kylemanna/kicad-library/README.md

# kicad-library
My personal KiCAD library
