kylemanna/kicad-library/3d/Molex_PicoBlade_530470710.step

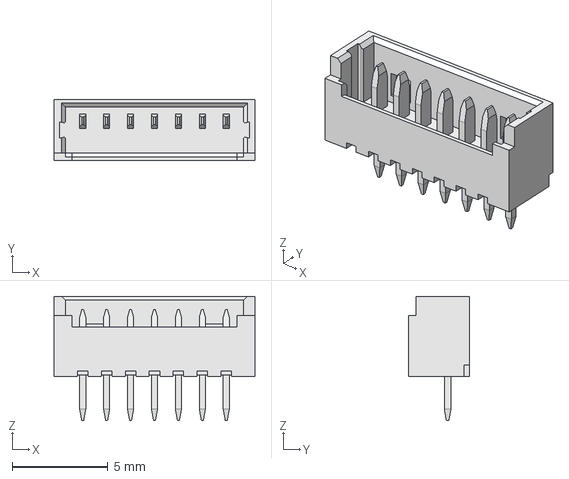
[picture p1: CAD file, 2016-03-12]
3d/Molex_PicoBlade_530470710.step
10.5 x 3.20 x 6.50 mm
