kylemanna/kicad-library/3d/Molex_PicoBlade_530470310.step

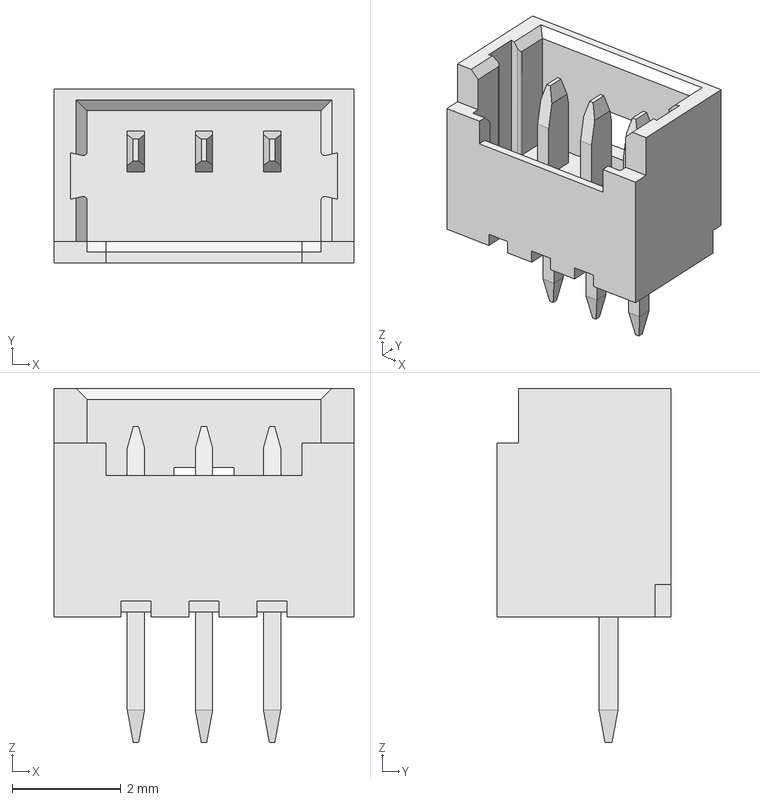
[picture p2: CAD file, 2016-03-12]
3d/Molex_PicoBlade_530470310.step
5.50 x 3.20 x 6.50 mm
