kylemanna/kicad-library/3d/Molex_PicoBlade_530470210.step

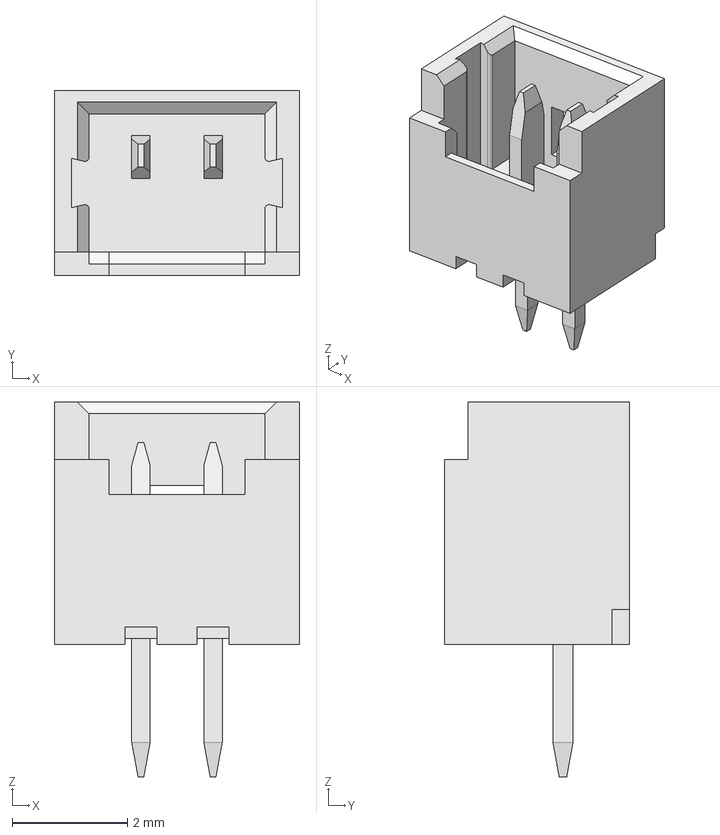
[picture p3: CAD file, 2016-03-12]
3d/Molex_PicoBlade_530470210.step
4.25 x 3.20 x 6.50 mm
