kylemanna/kicad-library/3d/B4B-XH-A.step

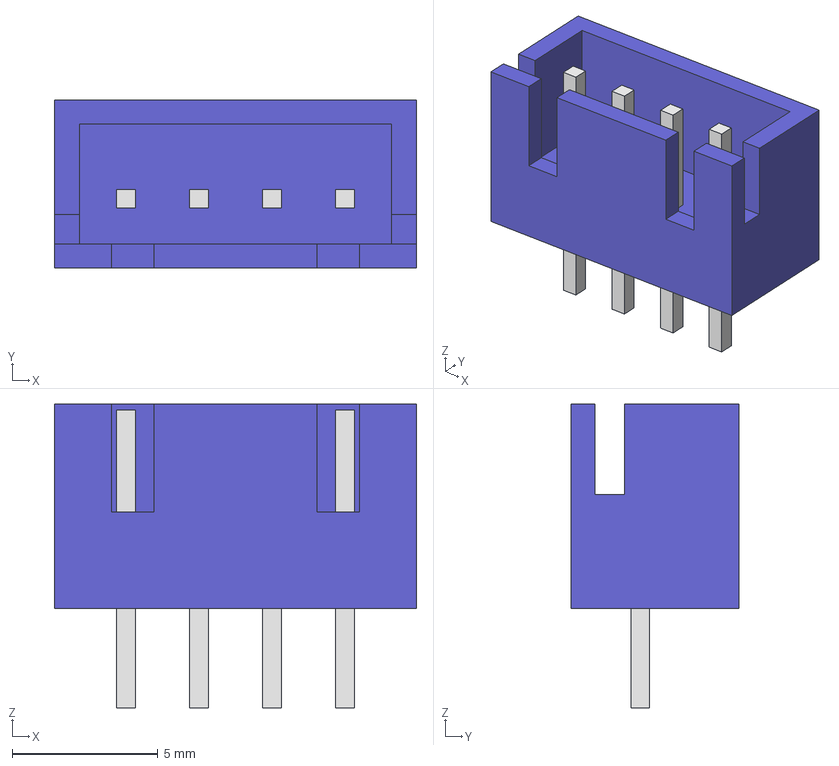
[picture p4: CAD file, 2016-02-24]
3d/B4B-XH-A.step
12.4 x 5.75 x 10.4 mm
