kylemanna/kicad-library/3d/B2B-XH-A.step

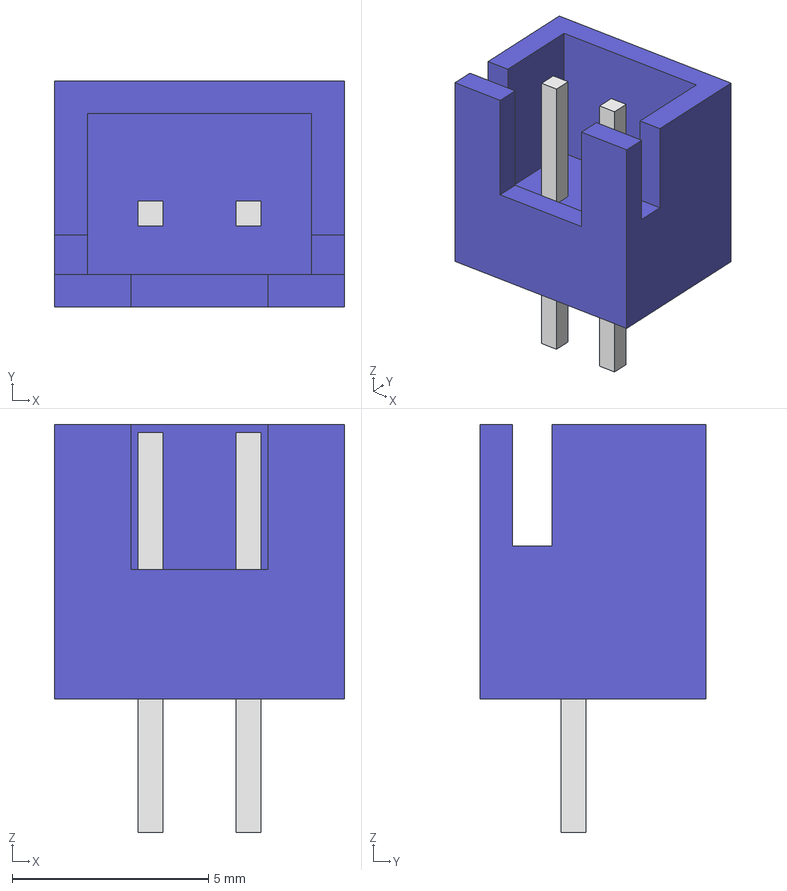
[picture p5: CAD file, 2016-02-20]
3d/B2B-XH-A.step
7.40 x 5.75 x 10.4 mm
