kylemanna/kicad-library/3d/LGA-16.step

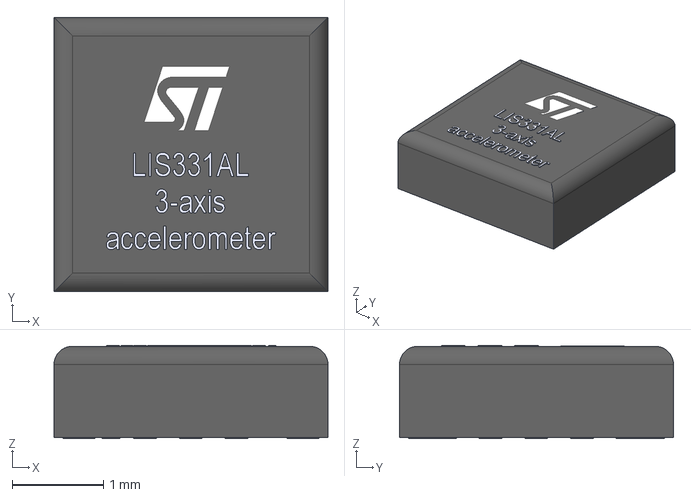
[picture p6: CAD file, 2016-02-16]
3d/LGA-16.step
3.00 x 3.00 x 1.02 mm
