kylemanna/kicad-library/3d/ABS07L.step

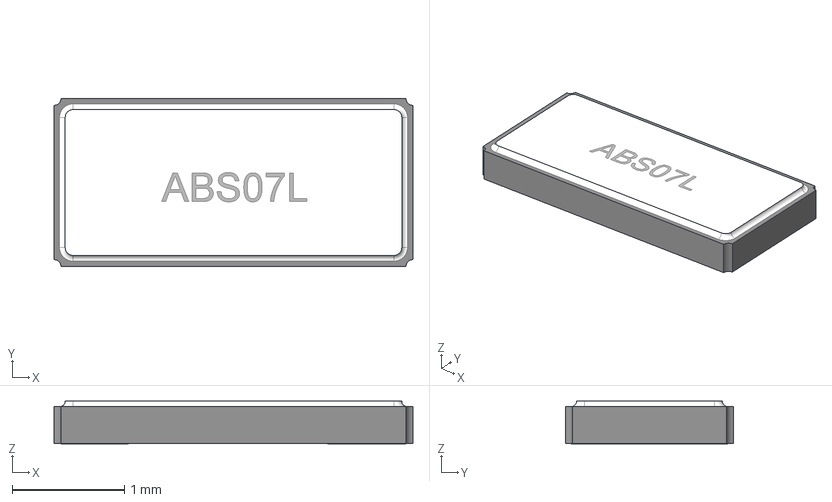
[picture p7: CAD file, 2016-02-16]
3d/ABS07L.step
3.20 x 1.50 x 0.383 mm
