kylemanna/kicad-library/3d/UE27AC54100.step

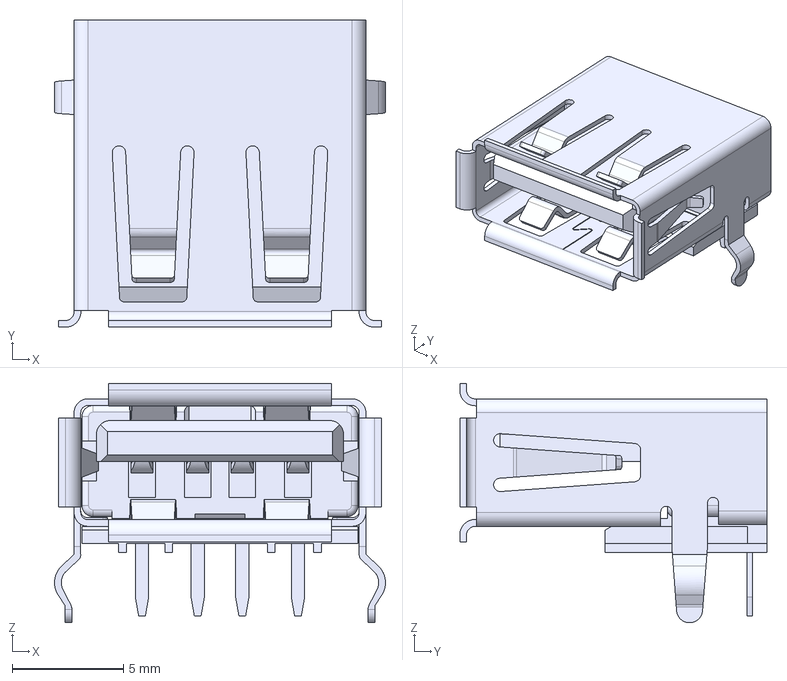
[picture p8: CAD file, 2016-02-12]
3d/UE27AC54100.step
14.9 x 13.8 x 10.7 mm
