kylemanna/kicad-library/3d/LED_5730.step

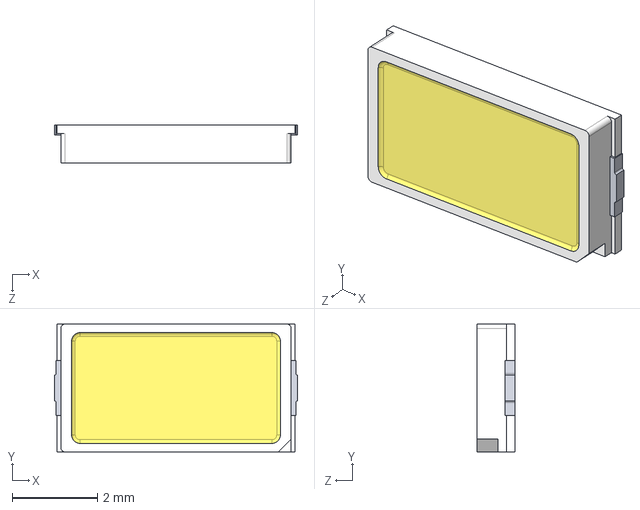
[picture p9: CAD file, 2016-01-27]
3d/LED_5730.step
5.70 x 3.00 x 0.9 mm
