kylemanna/kicad-library/3d/Pin_Header_Straight_2x05_1.27mm.step

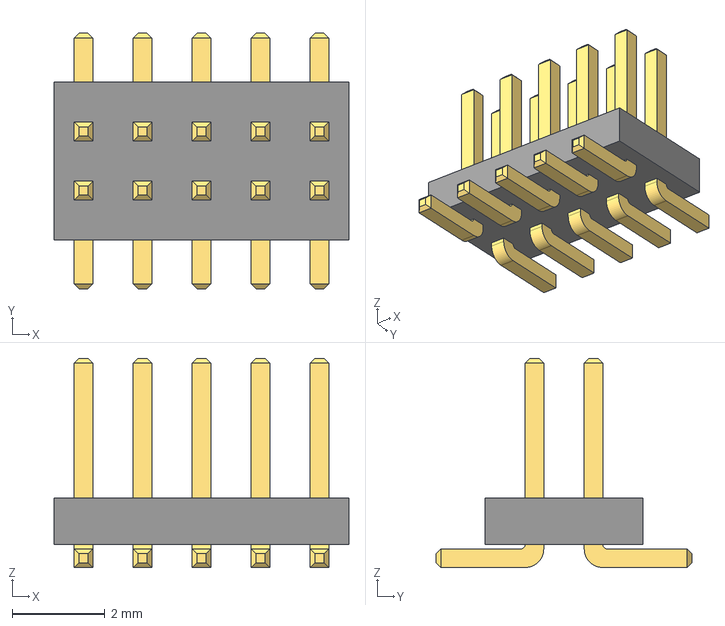
[picture p10: CAD file, 2016-01-26]
3d/Pin_Header_Straight_2x05_1.27mm.step
6.35 x 5.50 x 4.50 mm
