kylemanna/kicad-library/3d/LED_0603_B.step

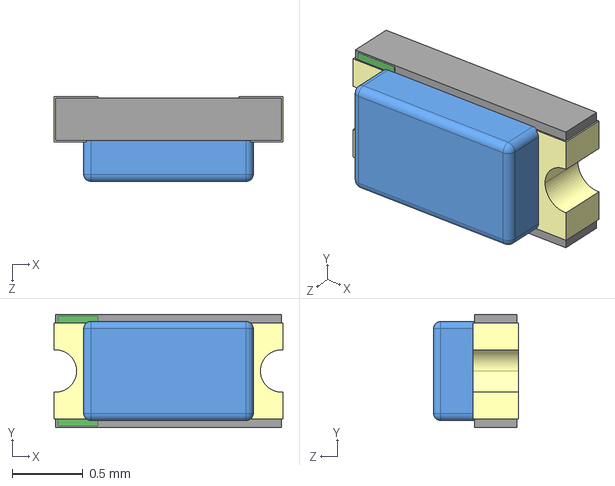
[picture p11: CAD file, 2016-01-26]
3d/LED_0603_B.step
1.62 x 0.8 x 0.6 mm
