kylemanna/kicad-library/3d/SOT89-5.step

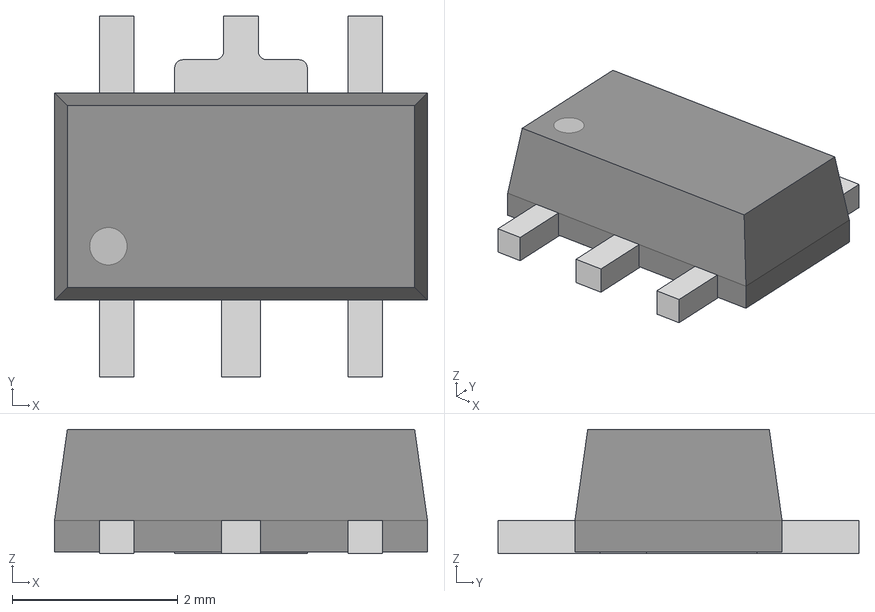
[picture p12: CAD file, 2016-01-24]
3d/SOT89-5.step
4.50 x 4.35 x 1.50 mm
