kylemanna/kicad-library/3d/MicroSMP.step

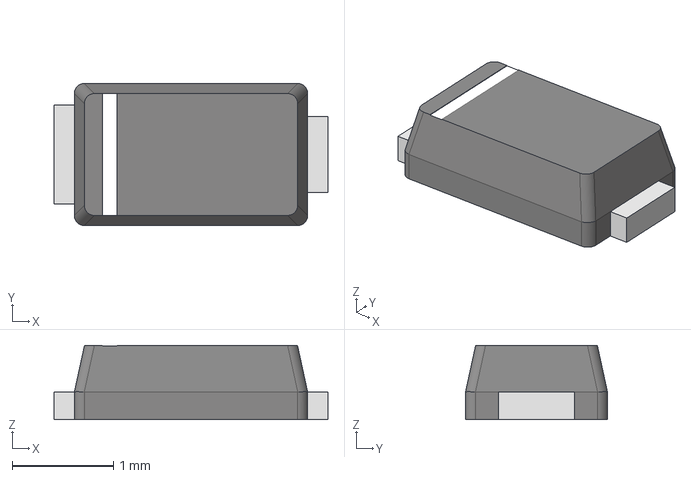
[picture p13: CAD file, 2016-01-23]
3d/MicroSMP.step
2.70 x 1.40 x 0.73 mm
