kylemanna/kicad-library/3d/PTS645.step

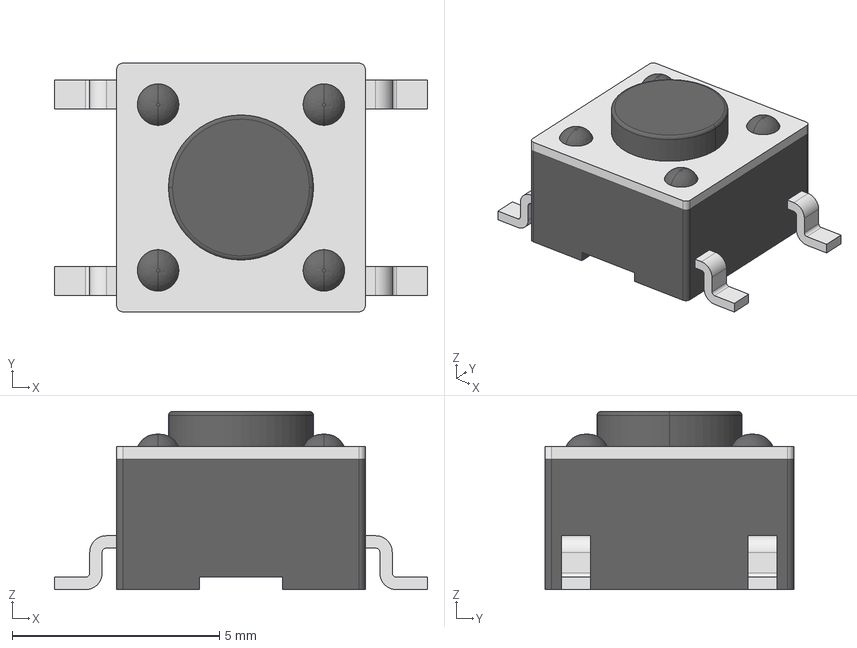
[picture p14: CAD file, 2016-01-23]
3d/PTS645.step
9.00 x 6.00 x 4.30 mm
