kylemanna/kicad-library/3d/PVQFN-N24.step

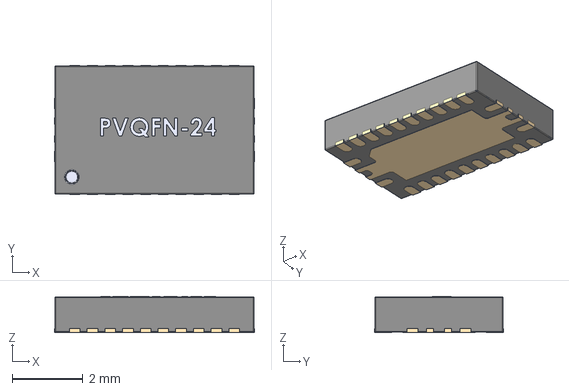
[picture p15: CAD file, 2016-01-23]
3d/PVQFN-N24.step
5.65 x 3.65 x 1.02 mm
