kylemanna/kicad-library/3d/NR3015.step

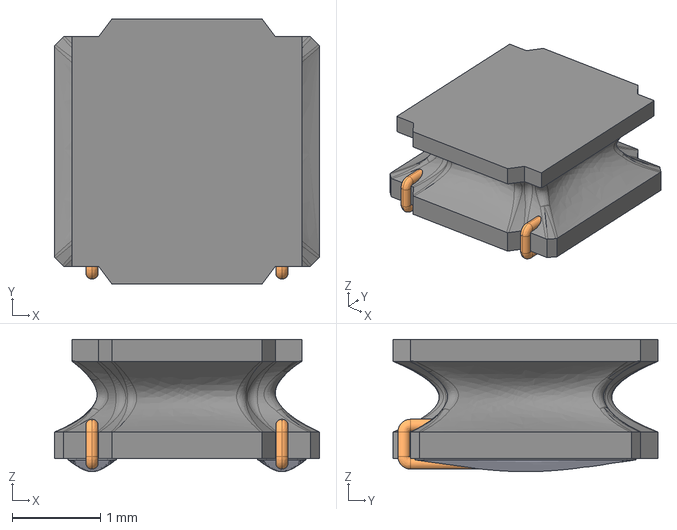
[picture p16: CAD file, 2016-01-23]
3d/NR3015.step
3.00 x 3.00 x 1.50 mm
