kylemanna/kicad-library/3d/VLP6045T.step

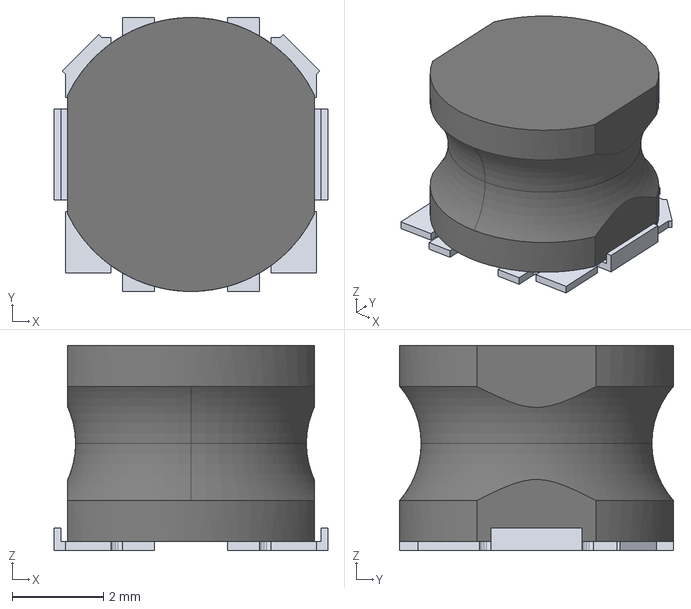
[picture p17: CAD file, 2016-01-23]
3d/VLP6045T.step
6.00 x 6.00 x 4.50 mm
