kylemanna/kicad-library/3d/S4B-XH-SM4-TB.step

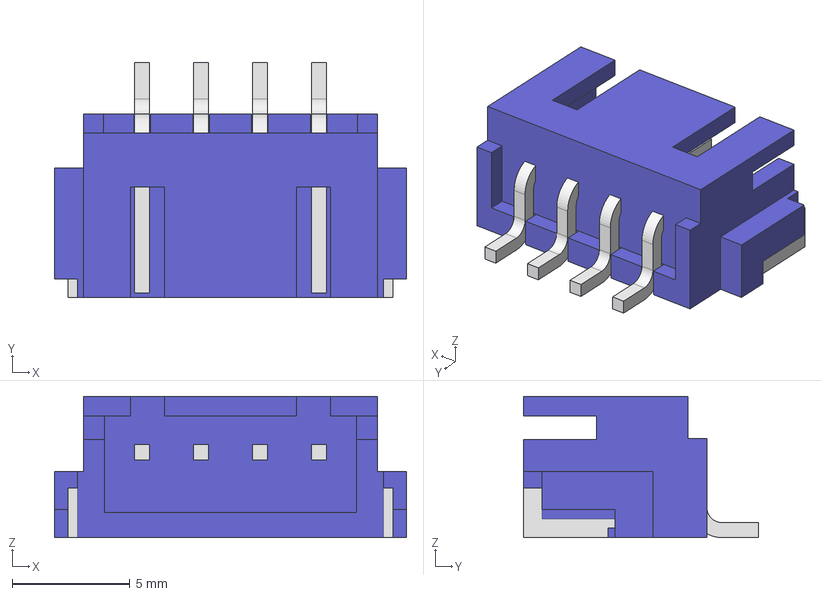
[picture p18: CAD file, 2016-01-23]
3d/S4B-XH-SM4-TB.step
14.9 x 10.0 x 6.00 mm
