kylemanna/kicad-library/3d/BM07B-SRSS-TB.step

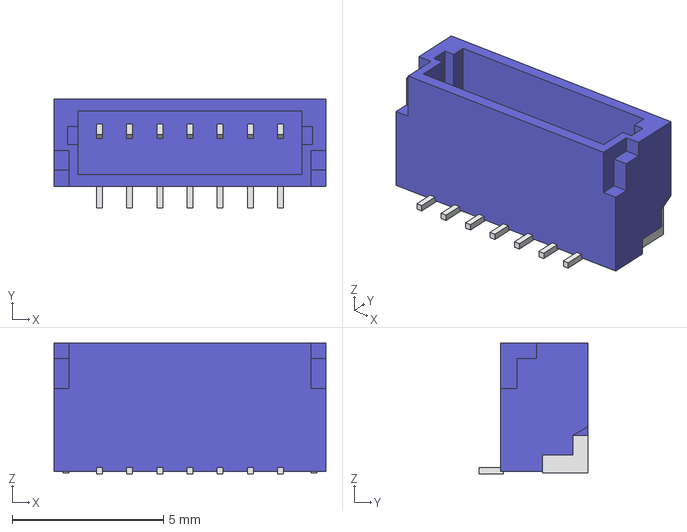
[picture p19: CAD file, 2016-01-23]
3d/BM07B-SRSS-TB.step
9.00 x 3.60 x 4.32 mm
