kylemanna/kicad-library/3d/S3B-XH-SM4-TB.step

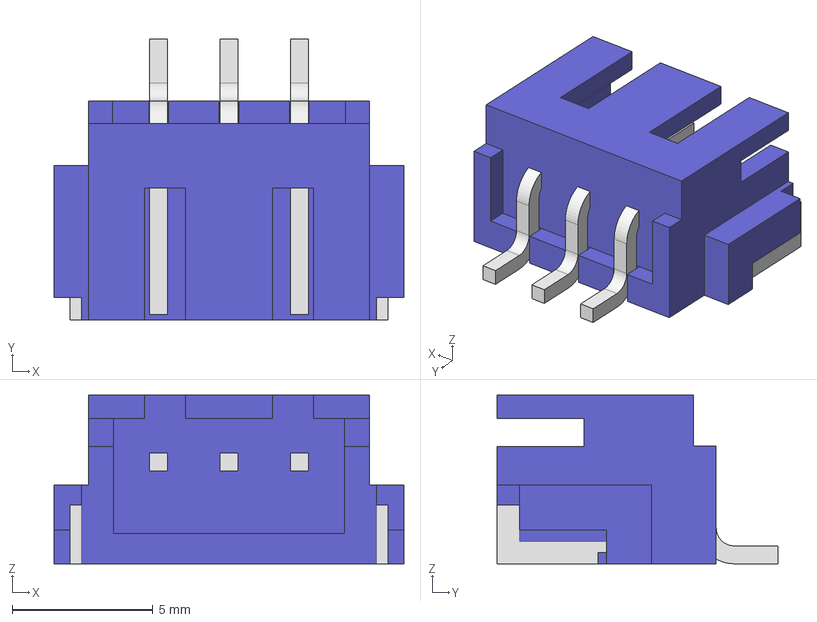
[picture p20: CAD file, 2016-01-23]
3d/S3B-XH-SM4-TB.step
12.4 x 10.0 x 6.00 mm
