kylemanna/kicad-library/3d/BM02B-SRSS-TB.step

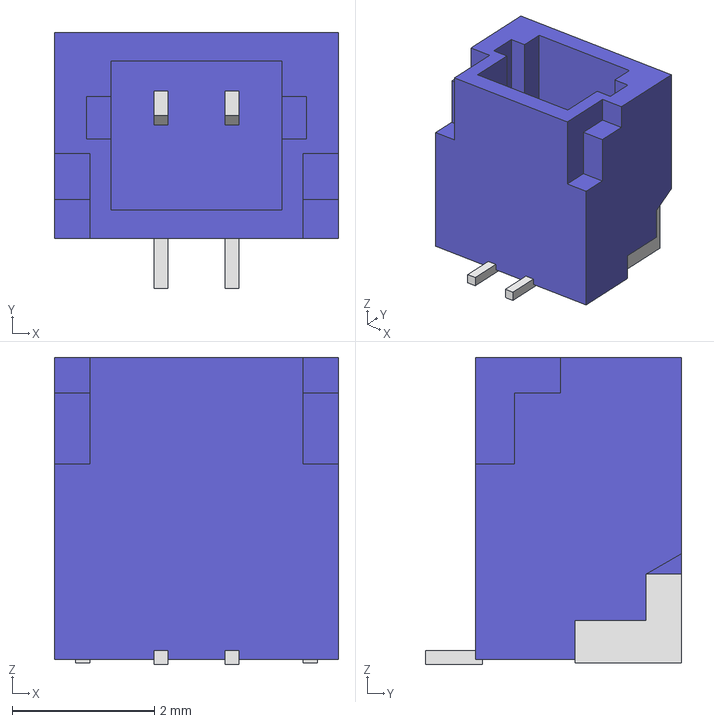
[picture p21: CAD file, 2016-01-23]
3d/BM02B-SRSS-TB.step
4.00 x 3.60 x 4.32 mm
