kylemanna/kicad-library/3d/SM02B-SRSS-TB.step

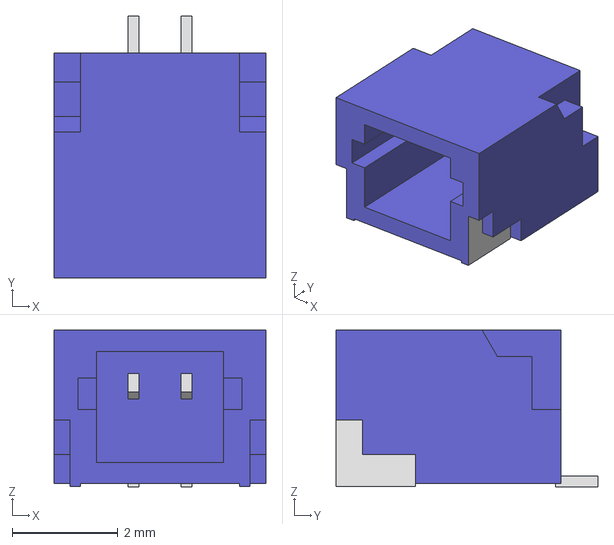
[picture p22: CAD file, 2016-01-23]
3d/SM02B-SRSS-TB.step
4.00 x 4.95 x 2.96 mm
