kylemanna/kicad-library/3d/BM05B-SRSS-TB.step

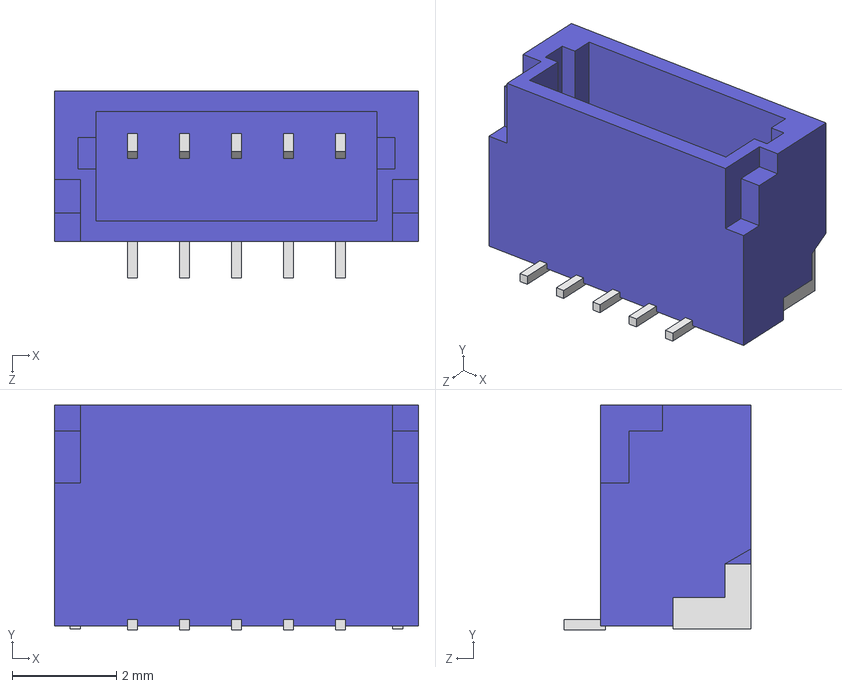
[picture p23: CAD file, 2016-01-23]
3d/BM05B-SRSS-TB.step
7.00 x 4.32 x 3.60 mm
