kylemanna/kicad-library/(list of files, cad)

Other CAD files:
3d/LED_0603_O.step
3d/LED_0603_G.step
3d/LED_0603_Y.step
3d/LED_0603_R.step
3d/10118194.step
