kylemanna/kicad-library/(commit log)

2015-12-11 user: Add ZXGD300x gate drivers
2015-12-16 user: Add some misc regulators
    * Add a buck and boost regulator
2015-12-28 user: Tweak LTC4412 pin ordering
    * Allows for cleaner schematics.
2015-12-29 user: Tweak SN65HVD230 pin ordering
    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
2015-12-30 user: Add AOZ3015/46 switching regulator
    * This part is very efficient with light loads.
2015-12-31 user: VOUT is an input on AOZ3015
    * For over voltage protection.
2016-01-04 footprint: Add AOZ3015PI SO-8 EP1
    * Footprint matches recommended land pattern.
2016-01-07 footprints: Add NR4018 and NR8040
    * Simple inductor footprints.
2016-01-07 footprints: Add JST XH 3 and 4 pin side entry
    * Industry standard JST-XH connector
2016-01-07 footprints: Add JST SH 2 and 6 pin side entry
    * Industry standard JST SH connector
2016-01-08 lib: Update pins for INA199/NCS199
    * Update the pin out for the SC70 package.
2016-01-09 symbol: Add MKV11Z128VLF7 symbol
    * Made with kipart
    [MKV11Z128VLF7.csv]
2016-01-09 symbol: Halfway re-work MKV11Z128VLF7
    * More work to follow.
    [MKV11Z128VLF7.csv]
2016-01-09 csv: Fix CLKOUT typo on MKV11Z128VLF7
    * Oops.
    [MKV11Z128VLF7.csv]
2016-01-10 symbol: Tweak layout of SWD pins for MKV11Z128VLF7
    * Runs directly to the 2x5 SWD connector.
2016-01-11 footprints: Add FA238/TSX3225
    * Copied from KiCAD Crystals lib
    * Changed the outline to be on F.Fab instead of F.Silk
    * Put edge markers on F.Silk that don't cross the pads
    * Reduced change of board house printing silkscreen on top of pads
2016-01-11 symbol: Tweak layout of XTAL pins for MKV11Z128VLF7
    * Works with KiCAD Crystal_SMD symbol now.
2016-01-11 footprints: Add JST-XH 3 and 4 pin SMT connectors
    * Sometimes holes are bad, SMT good.
2016-01-12 BQ2417x: Add symbol and footprint
    * Add symbol and footprint for battery charger.
    * Also add inductor footprint to go with it.
    [BQ2417x.csv]
2016-01-12 symbol: Add AP3211
    * Add a 1.4MHz / 1.5A async switching regulator.
2016-01-12 footprint: Add NR2412 layout
    * Add the layout for NRS2410/2 and NRH2410/2
2016-01-12 footprint: Add MicroSMP diode footprint
    * Used in the nice MSS2P3-M3/89A
2016-01-13 symbol: Fix some incorrect pin types
    * To appease the ERC.
2016-01-14 symbol: Add PT4115 LED driver
    * A constant current LED driver
2016-01-15 3d: WRL versions of JST-XH SMT connectors
    * Converterd from IGES files in FreeCAD
2016-01-15 footprint: 2x01x1.27mm pin header
    * Simple and handy.
2016-01-15 footprint: JST-XH: Clean-up footprint
    * Add nicer arrow to pin 1
    * Outline connector from 3D model
    * Add 3D model association
2016-01-16 3d: JST-SH 2 pin right angle
    * Add 3D model
    * Tweak footprint to work with model
    * Moved through hole model aside for now
2016-01-16 footprint+3D: Add JST-SH top entry 2 and 7 pin
    * Footprint
    * Model
2016-01-16 footprint+3D: Add JST-SH top entry 5 pin
    * Use STEP model instead of IGES this time.
    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
2016-01-16 3d: Update JST footprints to use STEP model
    * Looks better.
2016-01-16 3d: Fix scaling for JST-SH connectors
    * Scale the WRL file in mm to inches like KiCAD expects
    * 1/2.54 = .39370078740157480314
2016-01-16 3d: Add 3D model for MicroSMP diode
    Source: http://www.3dcontentcentral.com/secure/download-model.aspx?catalogid=171&id=356315
2016-01-16 footprint+3d: Add PTS645 switch
    * Footprint from KiCAD library
    * Model: http://www.3dcontentcentral.com/secure/download-model.aspx?catalogid=171&id=496245
2016-01-17 3d: Add PVQFN-N24 footprint
    * Also fix up bq24170 pins backwards
    Source: http://www.3dcontentcentral.com/download-model.aspx?catalogid=171&id=587450
2016-01-19 3d: Add 0603 LEDs
    * Scale seems a little off compared to library footprint
    * From 3D Content Central [1][2][3]
    [1] http://www.3dcontentcentral.com/secure/download-model.aspx?catalogid=171&id=442704
    [2] http://www.3dcontentcentral.com/secure/download-model.aspx?catalogid=171&id=442705
    [3] http://www.3dcontentcentral.com/secure/download-model.aspx?catalogid=171&id=442706
2016-01-22 footprints: Hacky vias for stitching
    * Idea is to put these in the layout for via stitching via the create
    array option and they don't need to be wired up like regular vias.
    * Problem is that they create an annular ring on all layers.
2016-01-23 step: Add STEP models from JST
    * All are misaligned though.
    [BM02B-SRSS-TB.step, BM05B-SRSS-TB.step, BM07B-SRSS-TB.step, S3B-XH-SM4-TB.step, S4B-XH-SM4-TB.step, SM02B-SRSS-TB.step]
2016-01-23 3d: Fix models for SM02B-SRSS-TB
    * Perfect axis orientation and offset now.
    [SM02B-SRSS-TB.step]
2016-01-23 3d: Fix models for other JST connectors
    * Perfect scaling, axis orientation and offset now.
    * Not sure why one VRML model is 180* off
    [BM02B-SRSS-TB.step, BM07B-SRSS-TB.step, S3B-XH-SM4-TB.step, S4B-XH-SM4-TB.step]
2016-01-23 3d: Rotate JST XH 4 pin
    * This was the model that had a 180* rotation which of course was wrong
    when exported. Fixed.
    [S4B-XH-SM4-TB.step]
2016-01-23 3d: Update VLP6045 model
    * All magic now.
    [VLP6045T.step]
2016-01-23 footprint+3d: Add NR3015
    * Add 3x3x1.5mm inductor.
    * Model from 3D Content Central
    [NR3015.step]
2016-01-23 3d: Add STEP model for PVQFN-N24
    * For Exporting the PCB from KiCad
    [PVQFN-N24.step]
2016-01-23 3d: Add STEP model for PTS645 switch
    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
    [PTS645.step]
2016-01-23 footprint: Fix PVQFN-24 3D model scaling
    * After correcting scaling in the model, the footprint file was forgoten.
2016-01-23 3d: Update MicroSMP/PowerDI-323/SOD323-FL
    * Update footprint. Something doesn't add up with respect to this
    model, the datasheets, and the recommended footprint.
    [MicroSMP.step]
2016-01-24 footprint+3d: Add SOT89-5 footprint
    * Tweak the SOT89-5 footprint from KiCAD library
    * Add STEP model [1]
    * Add WRL model
    [1] http://bit.ly/1OFSPWJ
    [SOT89-5.step]
2016-01-25 footprint: Hacky solution for bq24170 GND nets
    * The GND and GNDPWR nets are supposed to be tied together under the
    bq24170, however, KiCAD won't allow me to connect an inner layer net
    (GNDPWR) to a different outer layer net (GND).
    * Solution is to make the holes manually and have them joined by solder
    using the BQ24170_EP_TIE footprint. Passes DRC and should work
    almost as good.
2016-01-26 3d: Fix 0603 LED
    * LED was wonky, use this one [1] instead. Comes with configuations and
    works without any tweaking. Built by someone who cared.
    [1] http://bit.ly/1KAWAc4
    [LED_0603_B.STEP, LED_0603_G.STEP, LED_0603_O.STEP, LED_0603_R.STEP, LED_0603_Y.STEP]
2016-01-26 3d: Fix-up the 2x05 1.27mm Cortex SWD header
    * Nice and clean now.
    [Pin_Header_Straight_2x05_1.27mm.step]
2016-01-27 footprint: Clean-up JST XH 2 pin side entry with holes
    * Holes for wires if wanted
2016-01-27 footprint+3d: Add LED_5730
    * High power light in reasonable size
    [LED_5730.step]
2016-01-29 symbol: Add MK22FX512AVLH12
    * Add kipart csv.
    * Add raw generated part
    [MK22FX512AVLH12.csv]
2016-01-30 symbol: Add MDBT40 symbol
    * Add kipart csv
    * Add to user library
    [MDBT40.csv]
2016-02-01 symbols: Add MCP73831, TPS782, NCP551
    * Add 2 LDO regulators
    * Add 1 simple battery charger
2016-02-01 symbol: Update NMOS and PMOS to hide footprint
    * Don't need to see the footprint field in the schematic
2016-02-01 symbol: Add MIC5205 1% LDO
    * Add the MIC5205 1% LDO 150mA regulator
2016-02-03 symbol: Add LIS3DH accelerometer
    * Handy low power accelerometer
2016-02-09 footprint: Update LED 5730 to isolated EP
    * The exposed pad on various 5730 LEDs I've tested are sometimes anode
    and sometimes chathode. Instead float it for maximum flexibility.
    * Add LED schematic symbol so that the pad can be easily labeled.
2016-02-11 symbol: Add PAM2863 2A LED driver
    * Used with higher power LEDs.
2016-02-12 symbol: Tweak PAM242x pins and add aliases
    * Footprint is easier to connect and use.
2016-02-12 footprint+3d: Add USB Type-A connector
    * Large and in charge.
    [UE27AC54100.step]
2016-02-12 footprints: Add Micro USB Type B, fix Type-A
    * Add a proper model and footprint for a micro type-B.
    * Fix silkscreen for type-A.
    [10118194.step]
2016-02-16 3d+footprint: Add FC-135 Crystal
    * Used as 32.768kHz crystal oscillator.
    [ABS07L.step]
2016-02-16 3d+footprint: Add LGA-16
    * Useful for a LIS3xx accelerometer
    * 3D model says LIS331 for now
    [LGA-16.step]
2016-02-16 footprints: Add MDBT40 + SOIC-8-EP
    * Add the MDBT40 Bluetooth Module
    * Add SOIC-8 with a large exposed pad footprint
2016-02-19 symbol: Add TVS diode with shorter pins
    * The symbol in the kicad library is a monster.
2016-02-20 footprint: Update MDBT40 silkscreen
    * Don't plow over the pads. We have more style.
2016-02-20 footprint+3d: Add B2B-XH-A and B4B-XH-A
    * Add footprints for through hole 2 and 4 pin JST-XH connectors
    [B2B-XH-A.STEP, B4B-XH-A.STEP]
2016-02-20 footprints: Correct pin 1 layout
    * Reference was a physical connector housing
    * Also matches the circuit no 1. comment on the housing page
2016-02-22 symbol: Add MK22FN1M0AVLK12 K22 80pin LQFP
    * Add the 80 pin LQFP package because sometimes 64 pins isn't enough.
2016-02-24 3d: Convert STEP -> step
    * KiCAD StepUp expects lowercase filenames
    [B2B-XH-A.step, B4B-XH-A.step, LED_0603_B.step, LED_0603_G.step, LED_0603_O.step, LED_0603_R.step, LED_0603_Y.step]
2016-02-24 3d: Fix JST-XH 4-pin connector model
    * Not sure how this got molested, but fix it.
    [B4B-XH-A.step]
2016-03-12 footprint+3d: Molex PicoBlade 530470210
    * Add PicoBlade connectors
    [Molex_PicoBlade_530470210.step]
2016-03-12 footprint: Make F.Fab invisble
    * Less noise.
2016-03-12 footprint: Add PicoBlade 53047-0310
    * Molex 3 pin through hole vertical.
2016-03-12 3d: Add Molex PicoBlade 530470310
    * 3-pin, Vertical, Through Hole, 1.25mm pitch
    [Molex_PicoBlade_530470310.step]
2016-03-12 footprint+3d: Add PicoBlade 530470710
    * Add PicoBlade 7-pin, through hole, 1.25mm pitch, vertical header.
    [Molex_PicoBlade_530470710.step]
2017-05-01 symbols: Add TRS jack, TPA3128D2
    * Add 3.5mm headphone jack
    * Add TPA3128DR (aka TPA3118DR and TPA3116D2)
    * Tweak TPS54331 slightly
